HemanthSabbella/Dhvani/Docs/Schematic_check.docx

- Connections as per datasheets and tick the copy.
- Check the power calculations. Check back then but check again later on.
- FMC connector connections and standards. Mating is fine. Check the connection used. Mostly fine. Placement is also fine for support of board use scres and holders with insulation on it mounting on FPGA.
- LM1117 will work as suggested by deepak as well as SMD res on it. he LM1117 has thermal protection so it will just shut down if overheated. It shouldn't burn-out. If it shuts-down, add a bigger heatsink.

Schematic check done - remarks in orange

Only the 11v supply and 10V supply circuit’s components C and R are mismatched. 11V supply is not used and 10V can be given externally so chill.

Routing eariler check:

- Impedance matching?
- Length matching?
- Terminations?

Green is okay
