HemanthSabbella/Dhvani/PCB Design/PCB_power_exceptions/Exceptions/Routing _check.docx

- Making should be done for Vias.
- Differential Impedance is fine.
- Lengths are fine.
- Probe connector pin out is fine. Checked by placing.
