HemanthSabbella/Dhvani/ALS_probe/AL09BFEB00B-04.jpg

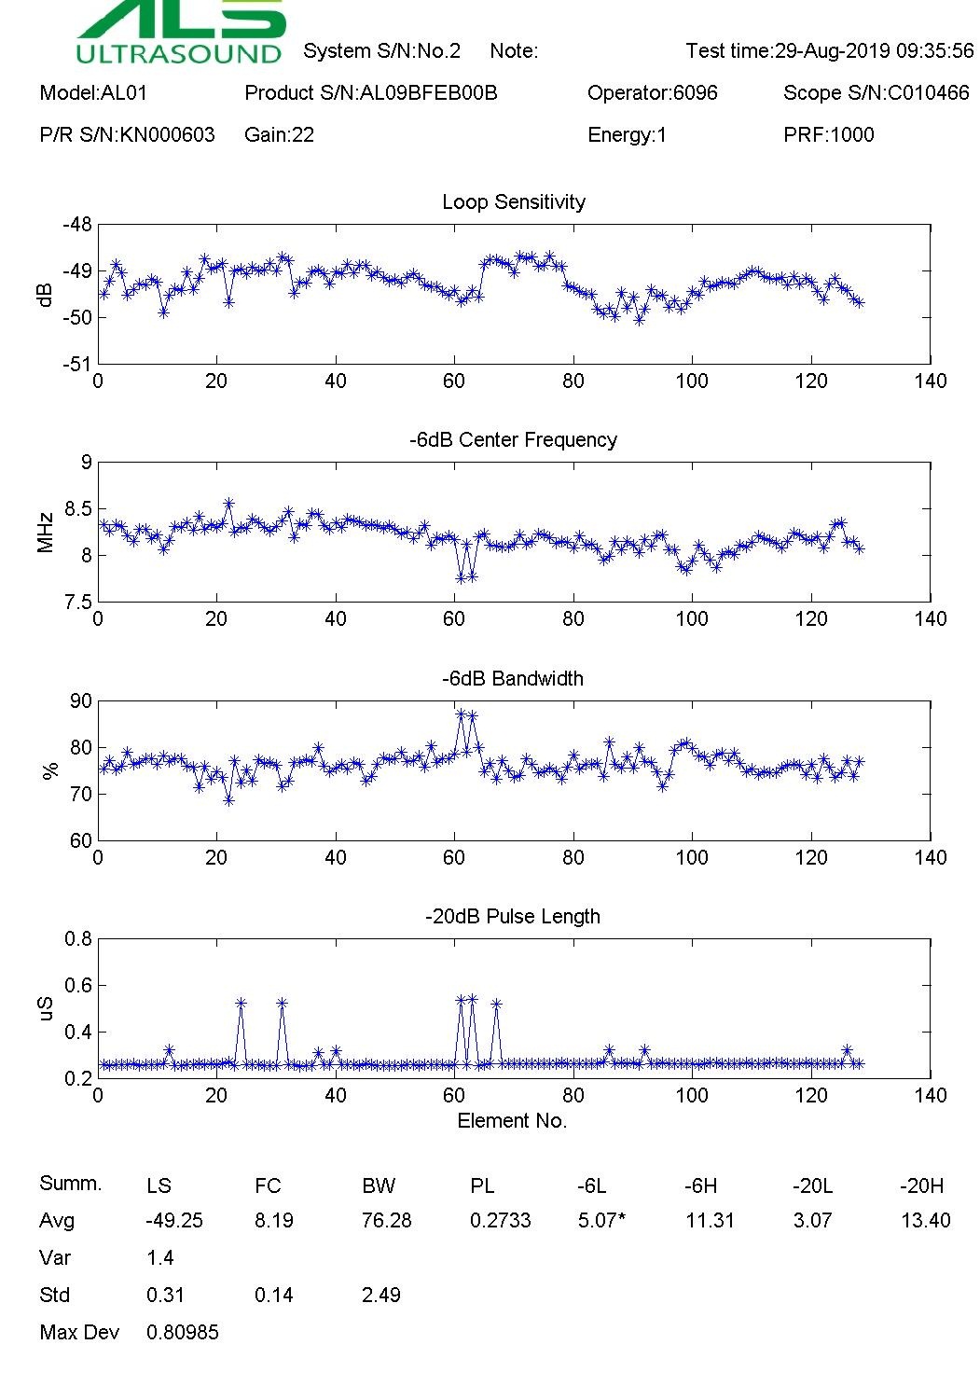
ALS_probe/AL09BFEB00B-04.jpg
