HemanthSabbella/Dhvani/ALS_probe/AL09BFEB00B-w04.jpg

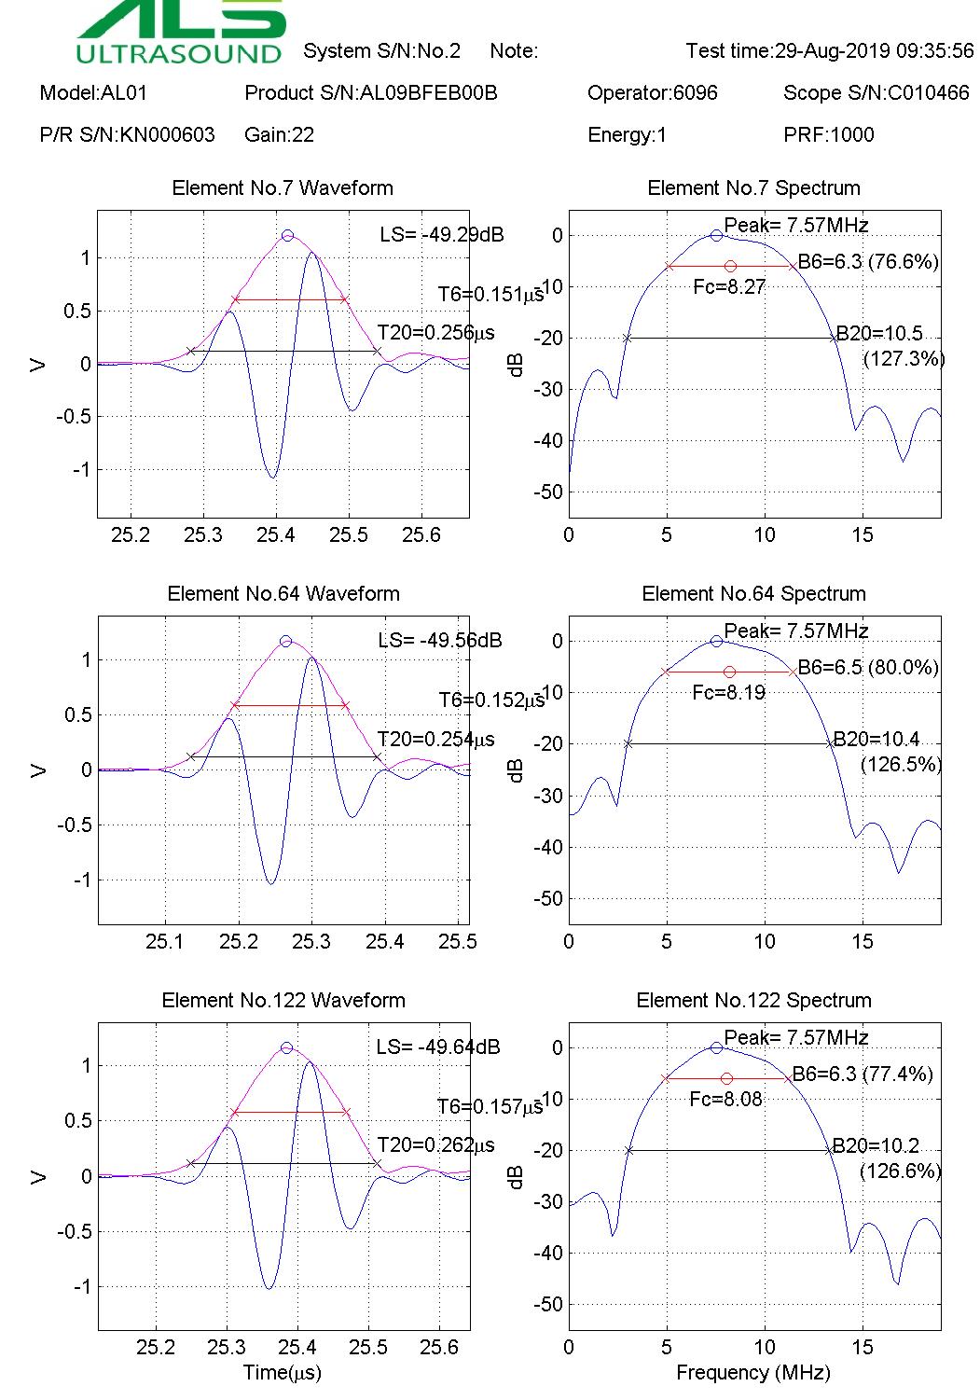
ALS_probe/AL09BFEB00B-w04.jpg
