HemanthSabbella/Dhvani/ALS_probe/C0300FEC218-01.jpg

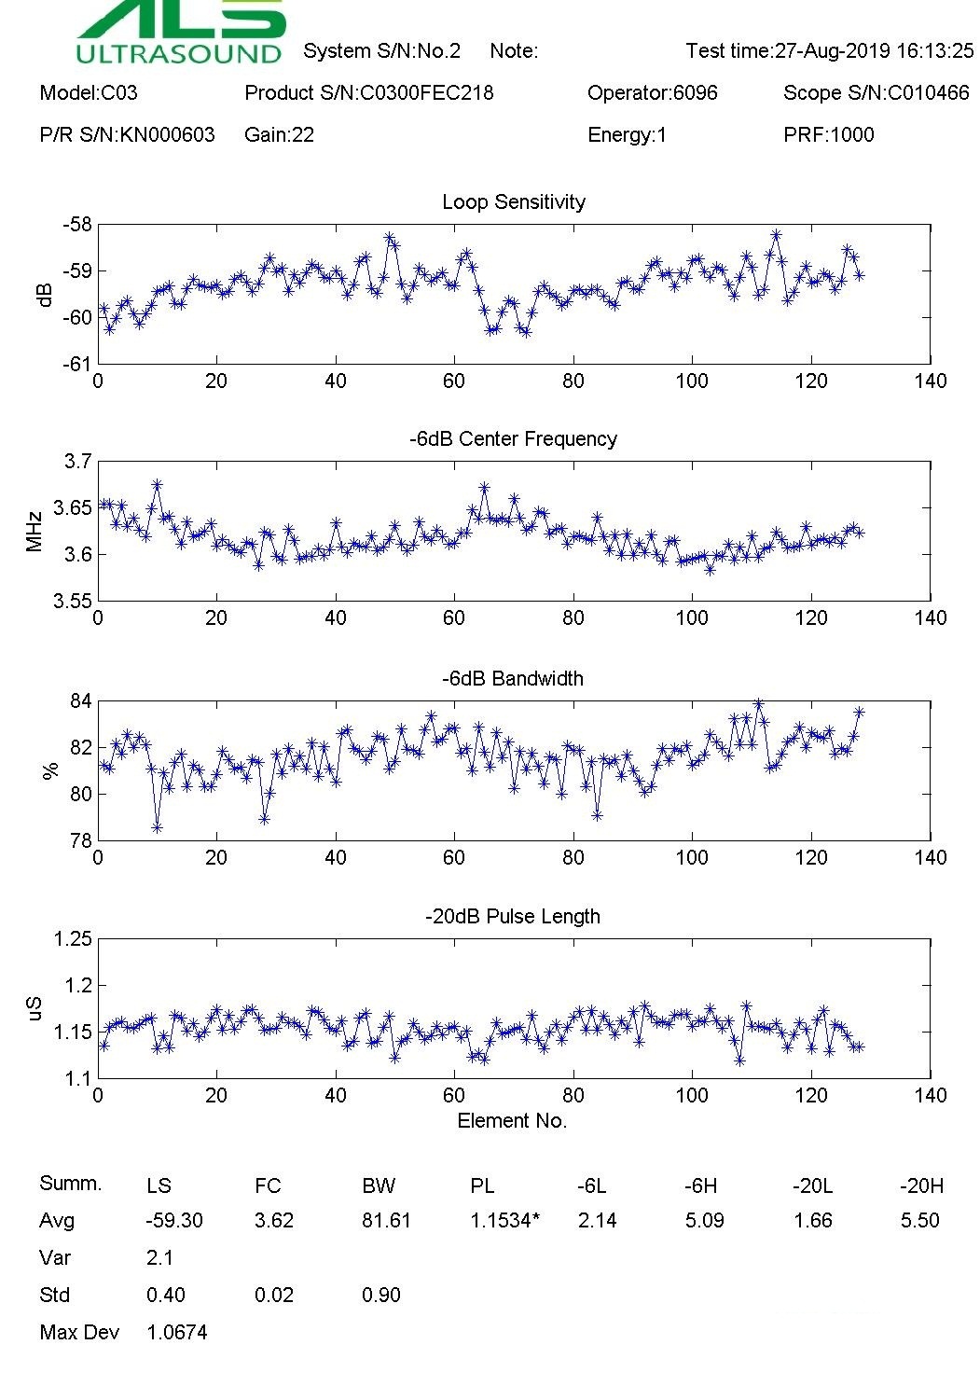
ALS_probe/C0300FEC218-01.jpg
