HemanthSabbella/Dhvani/ALS_probe/C0300FEC218-w01.jpg

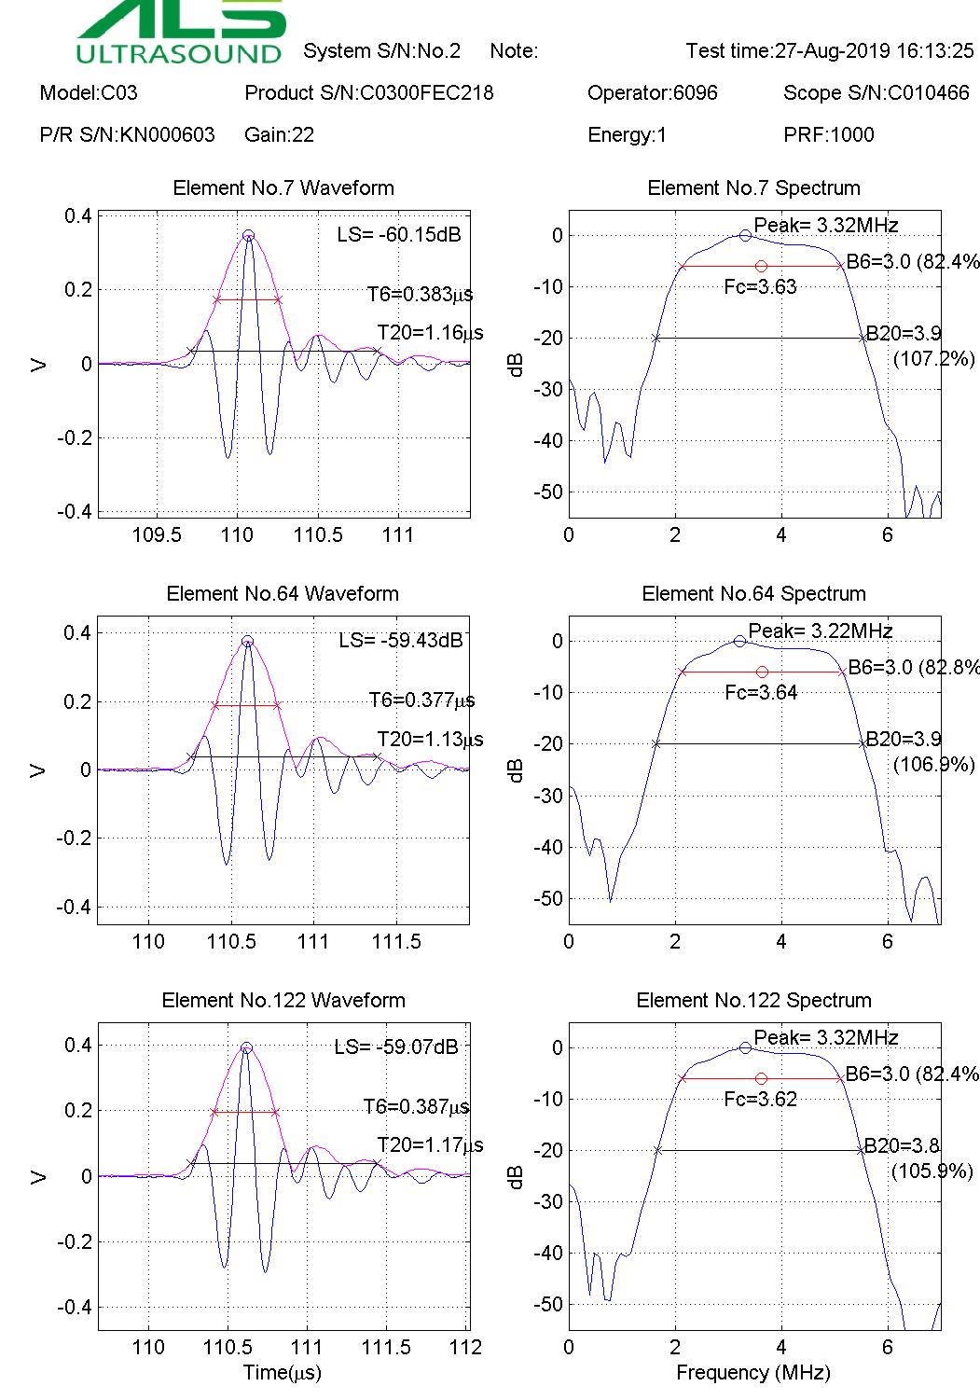
ALS_probe/C0300FEC218-w01.jpg
