HemanthSabbella/Dhvani/Docs/image.png

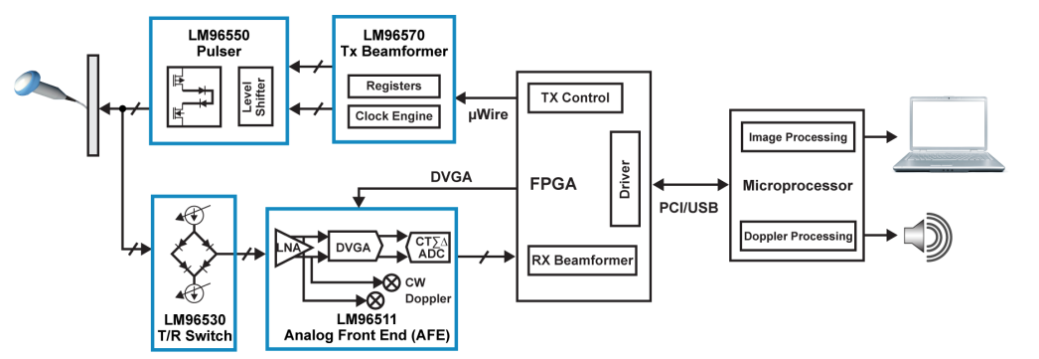
Docs/image.png
