HemanthSabbella/Dhvani/Ultrasound_DAS_BF_16channel_rawdata_for_Hemanth/DSBfm Mug2.jpg

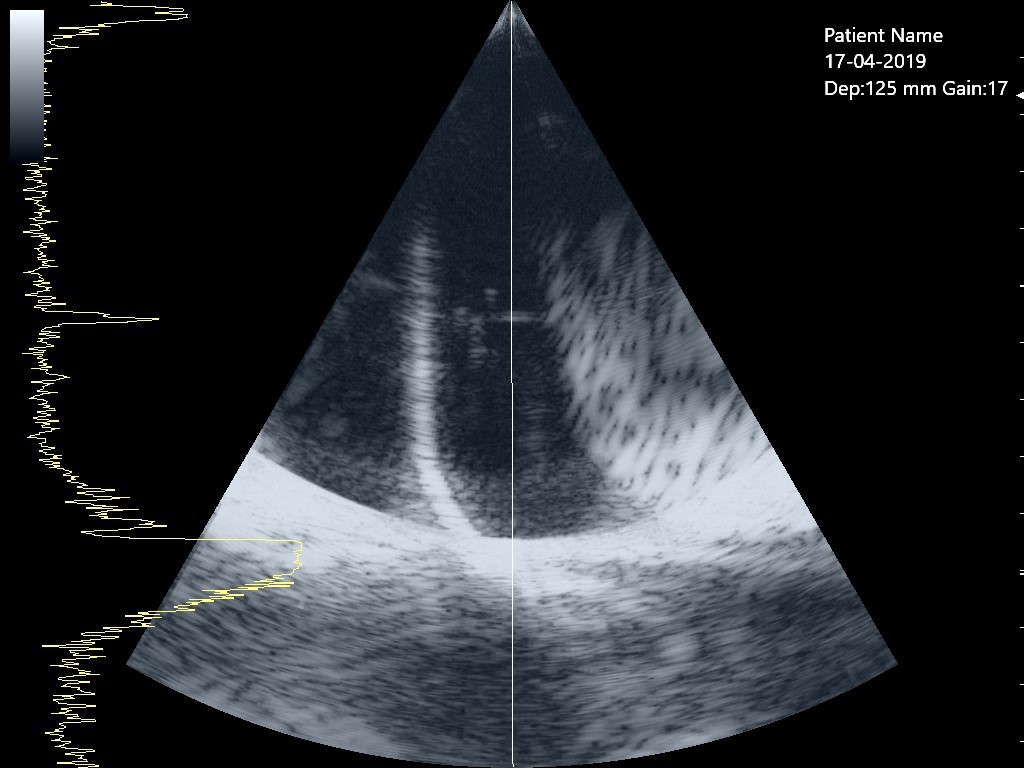
Ultrasound_DAS_BF_16channel_rawdata_for_Hemanth/DSBfm Mug2.jpg
