HemanthSabbella/Dhvani/PCB Design/BOM.ods

Component | Part number | Order Quantity per board | Total Quantity(2 boards)
Cap 100nF,10V C0805 | 885012207016 | 33 | 71
Cap 0.1uF,100V C0805 | MCSH21B104K101CT | 12 | 26
Cap 1uF,100V C0805 | GRJ21BC72A105KE11L | 12 | 26
Cap 2.2uF,25V C0805 | 0805F225Z250CT | 1 | 25
Cap 2.2uF,10V C0805 | VJ0805V225MXQTW1BC | 1 | 25
Cap 10uF,25V C0805 | GRM21BC71E106KE11L | 8 | 25
Cap 100uF,10V C0805 | C2012X5R1A226K125AB | 5 | 25
Cap 100uF,25V C0805 | 08053C224KAT2A | 2 | 25
Cap 10uF,10V E2,5- 6 | MCGPR16V106M5X11-RH | 2 | 4
Cap 0.1uF,25V C0805 | MC0805B104M250CT | 8 | 25
Cap 1uF,25V C0805 | 0805F105Z250CT | 8 | 25
Cap 1uF,10V C0805 | 885012207022 | 9 | 25
MPZ1608S101ATAH0 | MPZ1608S101ATAH0 | 1 | 25
DCJ0202 | 33DCJ-0202-A | 1 | 2
ASP-134488-01 | ASP-134488-01 | 1 | 2
742792031 | 742792031 | 1 | 25
LM96570SQE/NOPB | LM96570SQE/NOPB | 1 | 2
JP8Q | Standard 2.54mm pitch with header jumper | 2 | 4
NTF3055L108T1G | NTF3055L108T1G | 1 | 2
Res 33 M0805 | MCWR08X33R0FTL | 22 | 48
Res 120 M0805 | MCWR08X1200FTL | 5 | 25
Res 16 M0805 | MCWR08X16R0FTL | 1 | 25
Res 125 M0805 | 126 ohm# TNPW0805126RBEEA | 2 | 25
Res 85 M0805 | 86.6ohm # RT0805BRD0786R6L | 1 | 25
Res 10k M0805 | MCWR08X1002FTL | 1 | 25
Res 11k M0805 | MCWR08X1102FTL | 1 | 25
Res 11.5k M0805 | ERJ-6ENF1152V | 1 | 25
Res 18 M0805 | MCWR08X18R0FTL | 1 | 25
Res 1K M0805 | RC0805JR-071KL | 10 | 25
MA09-1 | 9x1 Header Male Berg Strip 2.54mm Pitch | 1 | 2
MA10-1 | 10x1 Header Male Berg Strip 2.54mm Pitch | 2 | 4
MA04-1 | 4x1 Header Male Berg Strip 2.54mm Pitch | 2 | 4
MA03-1 | 3x1 Header Male Berg Strip 2.54mm Pitch | 1 | 2
MA08-1 | 8x1 Header Male Berg Strip 2.54mm Pitch | 1 | 2
MA06-1 | 6x1 Header Male Berg Strip 2.54mm Pitch | 2 | 4
MA10-2 | 10x2 Header Male Berg Strip 2.54mm Pitch | 1 | 2
PROBE_CONNECTOR | 6565204-1 | 1 | 2
5PB1108PGGI | 5PB1108PGGI | 1 | 2
MAX2082CXD+ | MAX2082CXD+ | 1 | 2
MAX6225BCSA+ | MAX6225BCSA+ | 1 | 2
MAX4968AECM+ | MAX4968AECM+ | 8 | 16
LM1117T-3.3/NOPB | LM1117T-3.3/NOPB | 1 | 2
LM1117T-5.0/NOPB | LM1117T-5.0/NOPB | 1 | 2
LM1117T-ADJ/NOPB | LM1117T-ADJ/NOPB | 3 | 6
LD1117V18 | LD1117V18 | 2 | 4
TL7660CDGKR | TL7660CDGKR | 1 | 2
MAX6819UT+ | MAX6819UT+ | 1 | 2
AK500/2 | 30.702 | 4 | 8
