HemanthSabbella/Dhvani/Layout_final/Final/GERBER for MAX2082_transceiver_V1.0/4 Layer Impedance calculation.xls

 |  |  | Layer stack up
 | L1 | TOP | 0.035 |  | Finish Copper
 |  |  | 0.210 |  | prepregs
 | L2 | PWR/GND | 0.035 |  | Inner layer
 |  |  | 1.000 |  | 1/1 1.00 mm Laminate
 | L3 | PWR/GND | 0.035 |  | Inner layer
 |  |  | 0.210 |  | prepregs
 | L4 | BOTTOM | 0.035 |  | Finish Copper
 | Total Thickness |  | 1.56 +/-10% mm
 | Layer | Impedance types | Reference layer | Suggested Gerber trace width / Spacing |  | Required Impedance | Achieved impedance
 | L1 | Differential | L2 | 8.00 MIL/ 5.80MIL |  | 100 ohm | 100.16 ohm +/-10%
 | L4 | Differential | L3 | 8.00 MIL/ 5.80MIL |  | 100 ohm | 100.16 ohm +/-10%
Note:1)Above calculation based on 4.3mm dielectric constant of available material
Note:2)Above calculation based on available material with us recently.
Note:3)Above calculation are theoretically, impedance practical values may changed in +/-10%
