HemanthSabbella/Dhvani/PCB Design/PCB_power_exceptions/Exceptions/1/Project.pdf

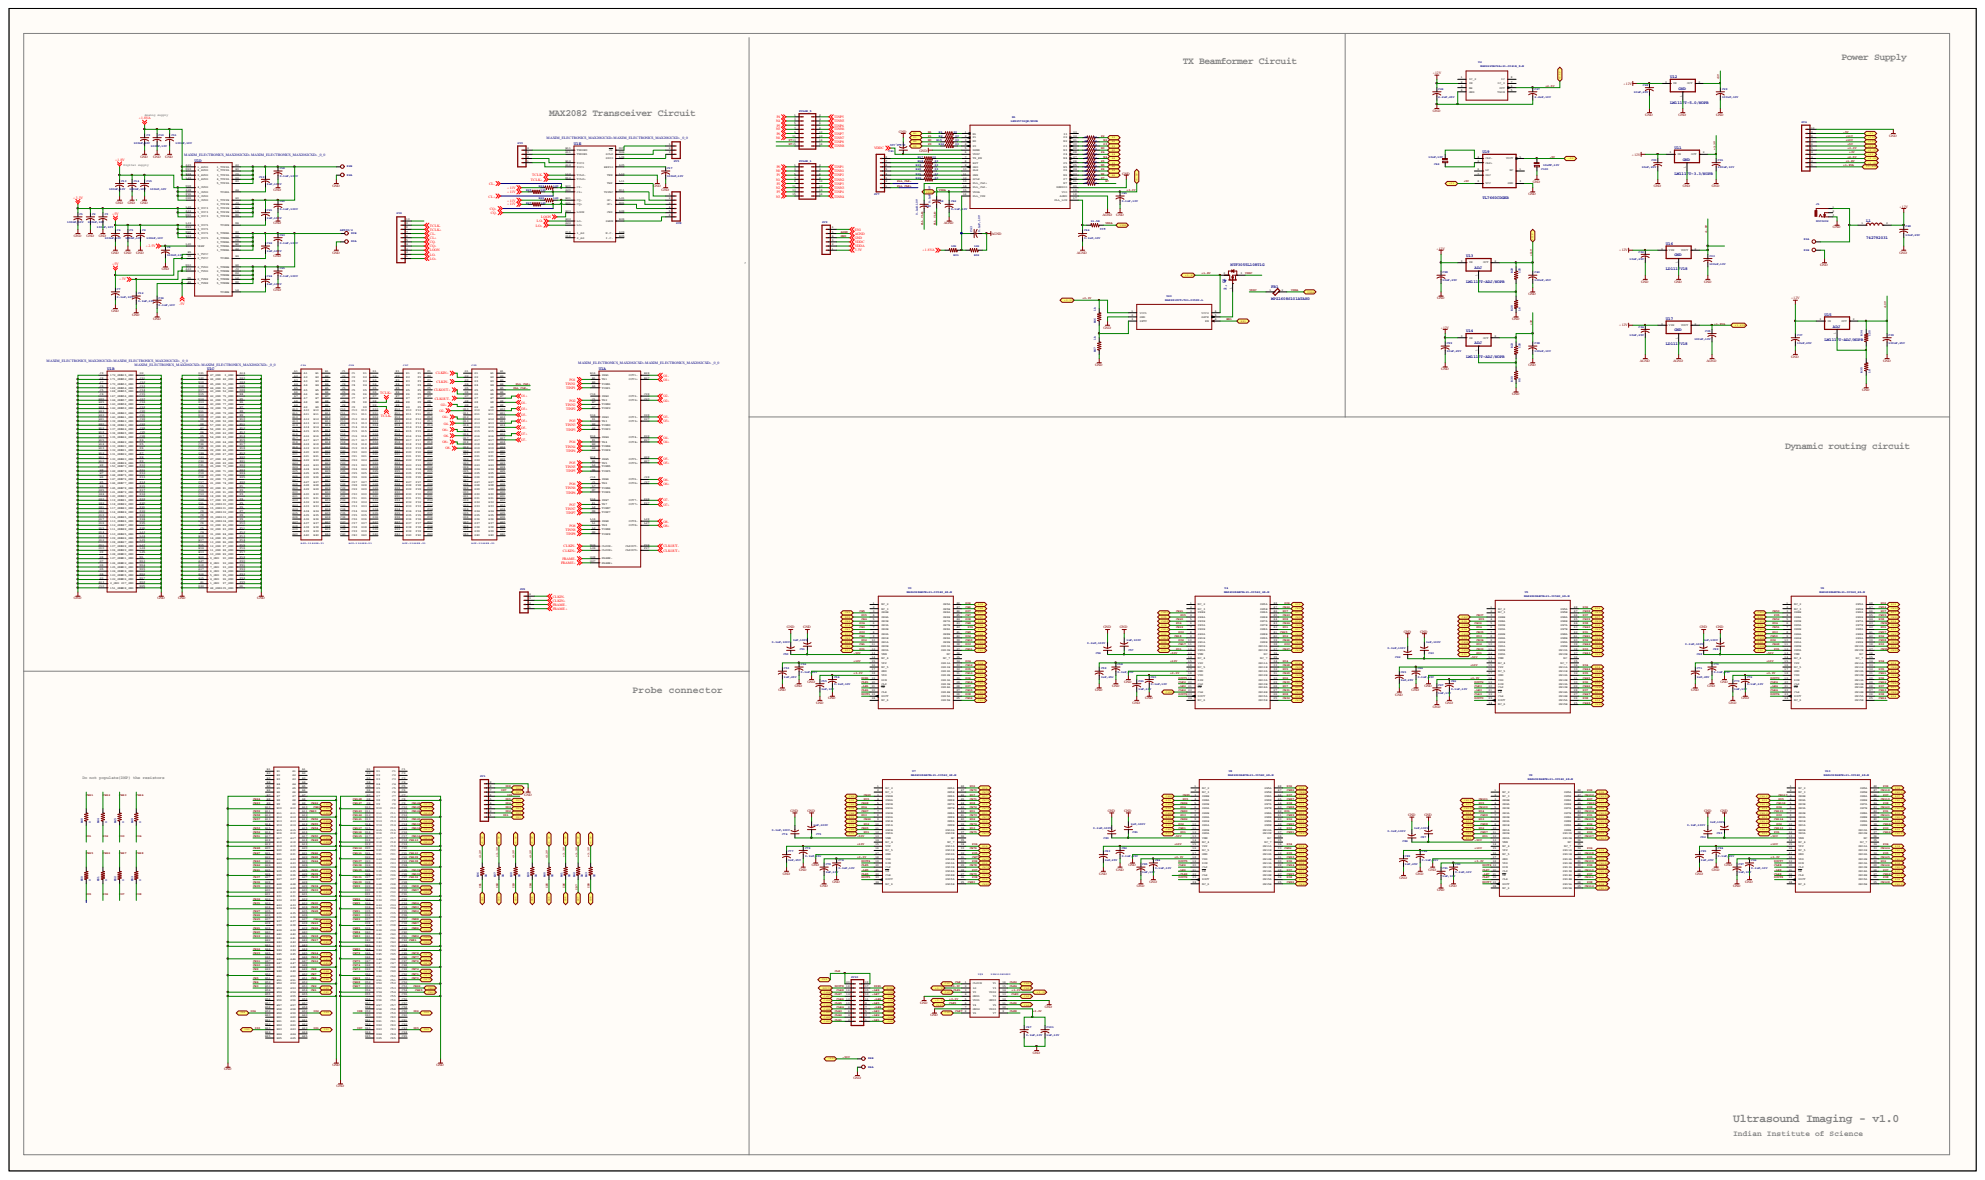
[picture p10: page 1]

Do not populate(DNP) the resistors

Indian Institute of Science
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
