HemanthSabbella/Dhvani/PCB Design/PCB_power_exceptions/Exceptions/2/MAX2082_transceiver_V1.0.pdf

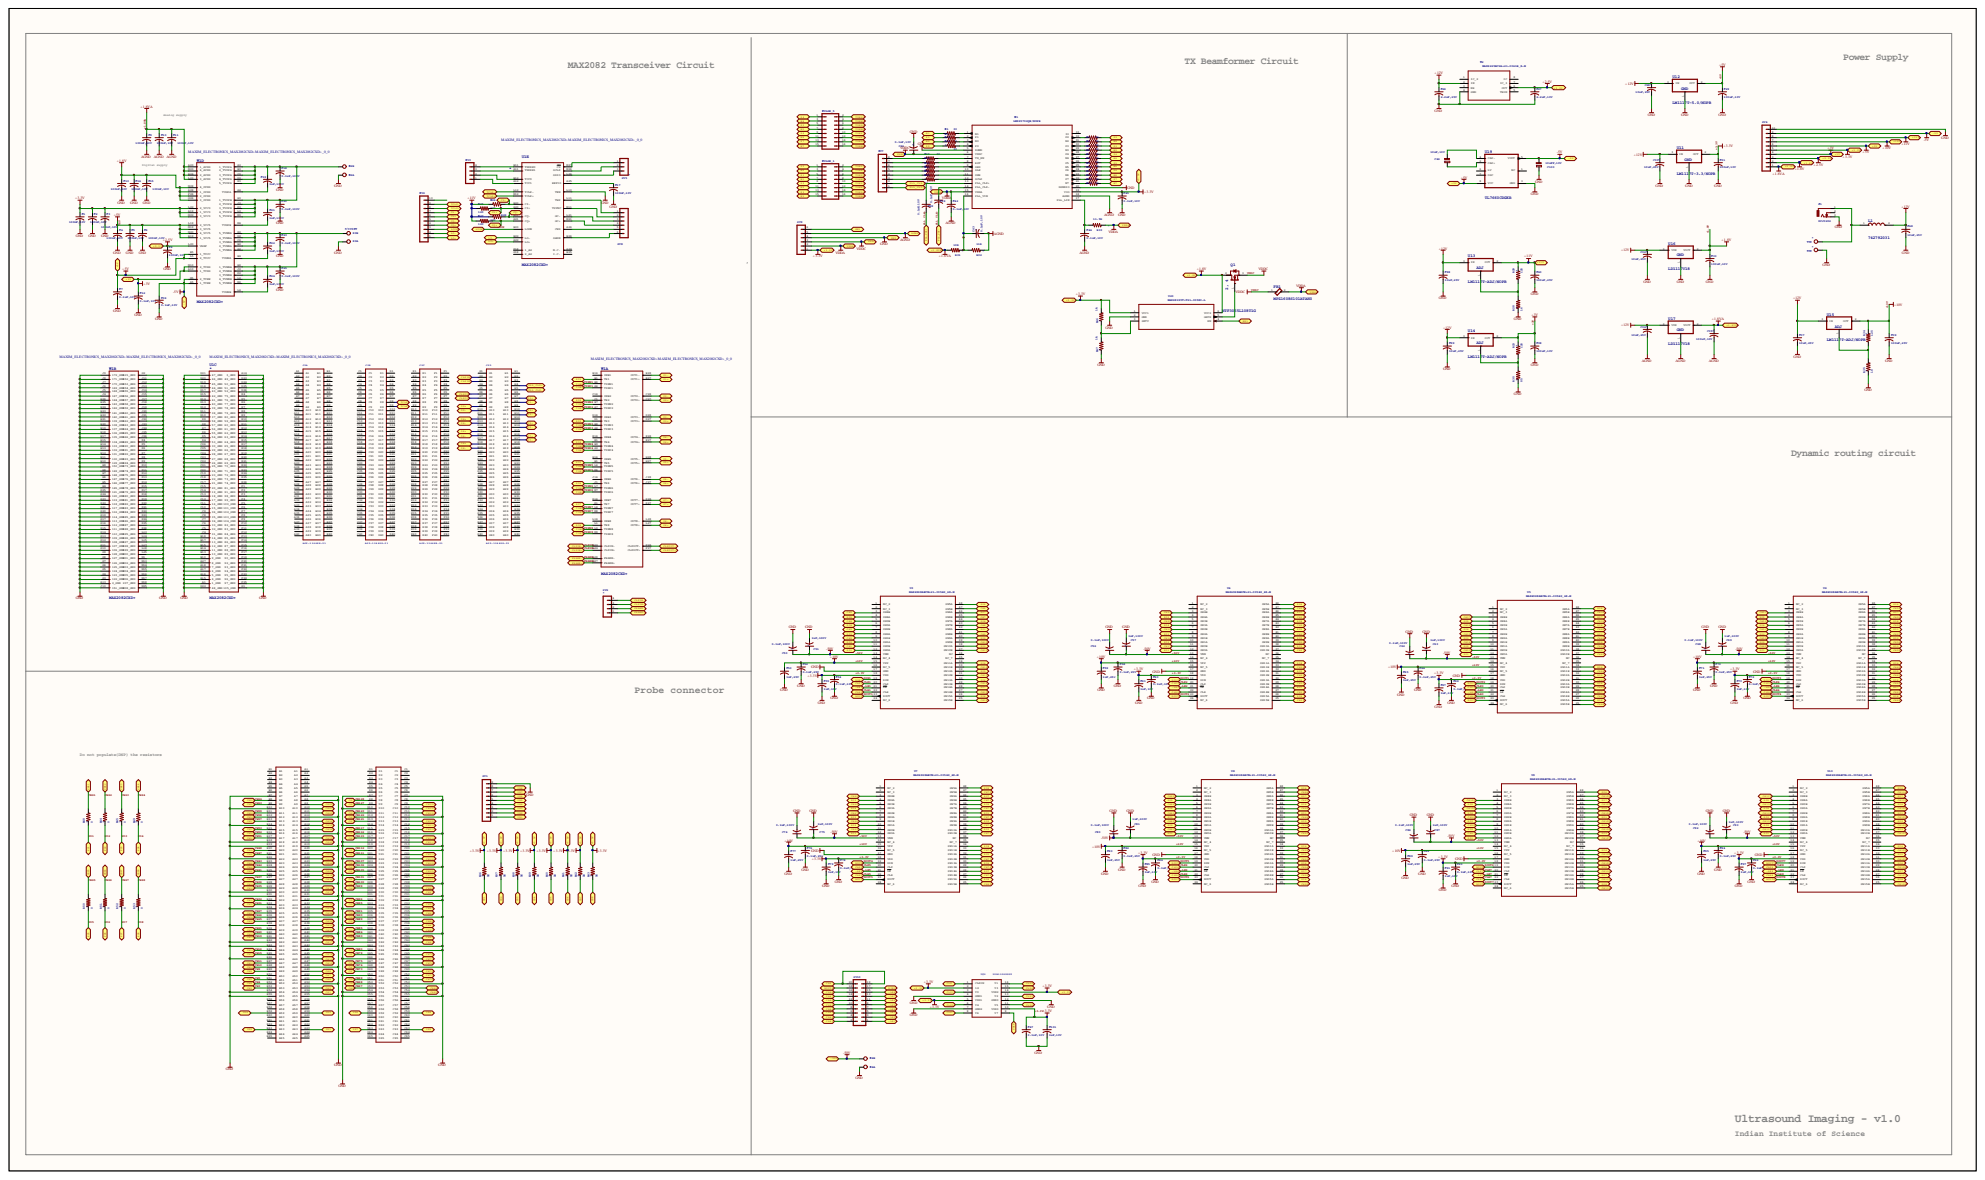
[picture p11: page 1]

Do not populate(DNP) the resistors

Indian Institute of Science
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
