HemanthSabbella/Dhvani/(list of files, drawings)

Other design files:
Layout_final/Final/MAX2082_transceiver_V1.0.PrjPcb
Layout_final/Final/MAX2082_transceiver_V1.0.SchDoc
